Spelieye/superlooper/pdfs/superlooper_schematic.pdf

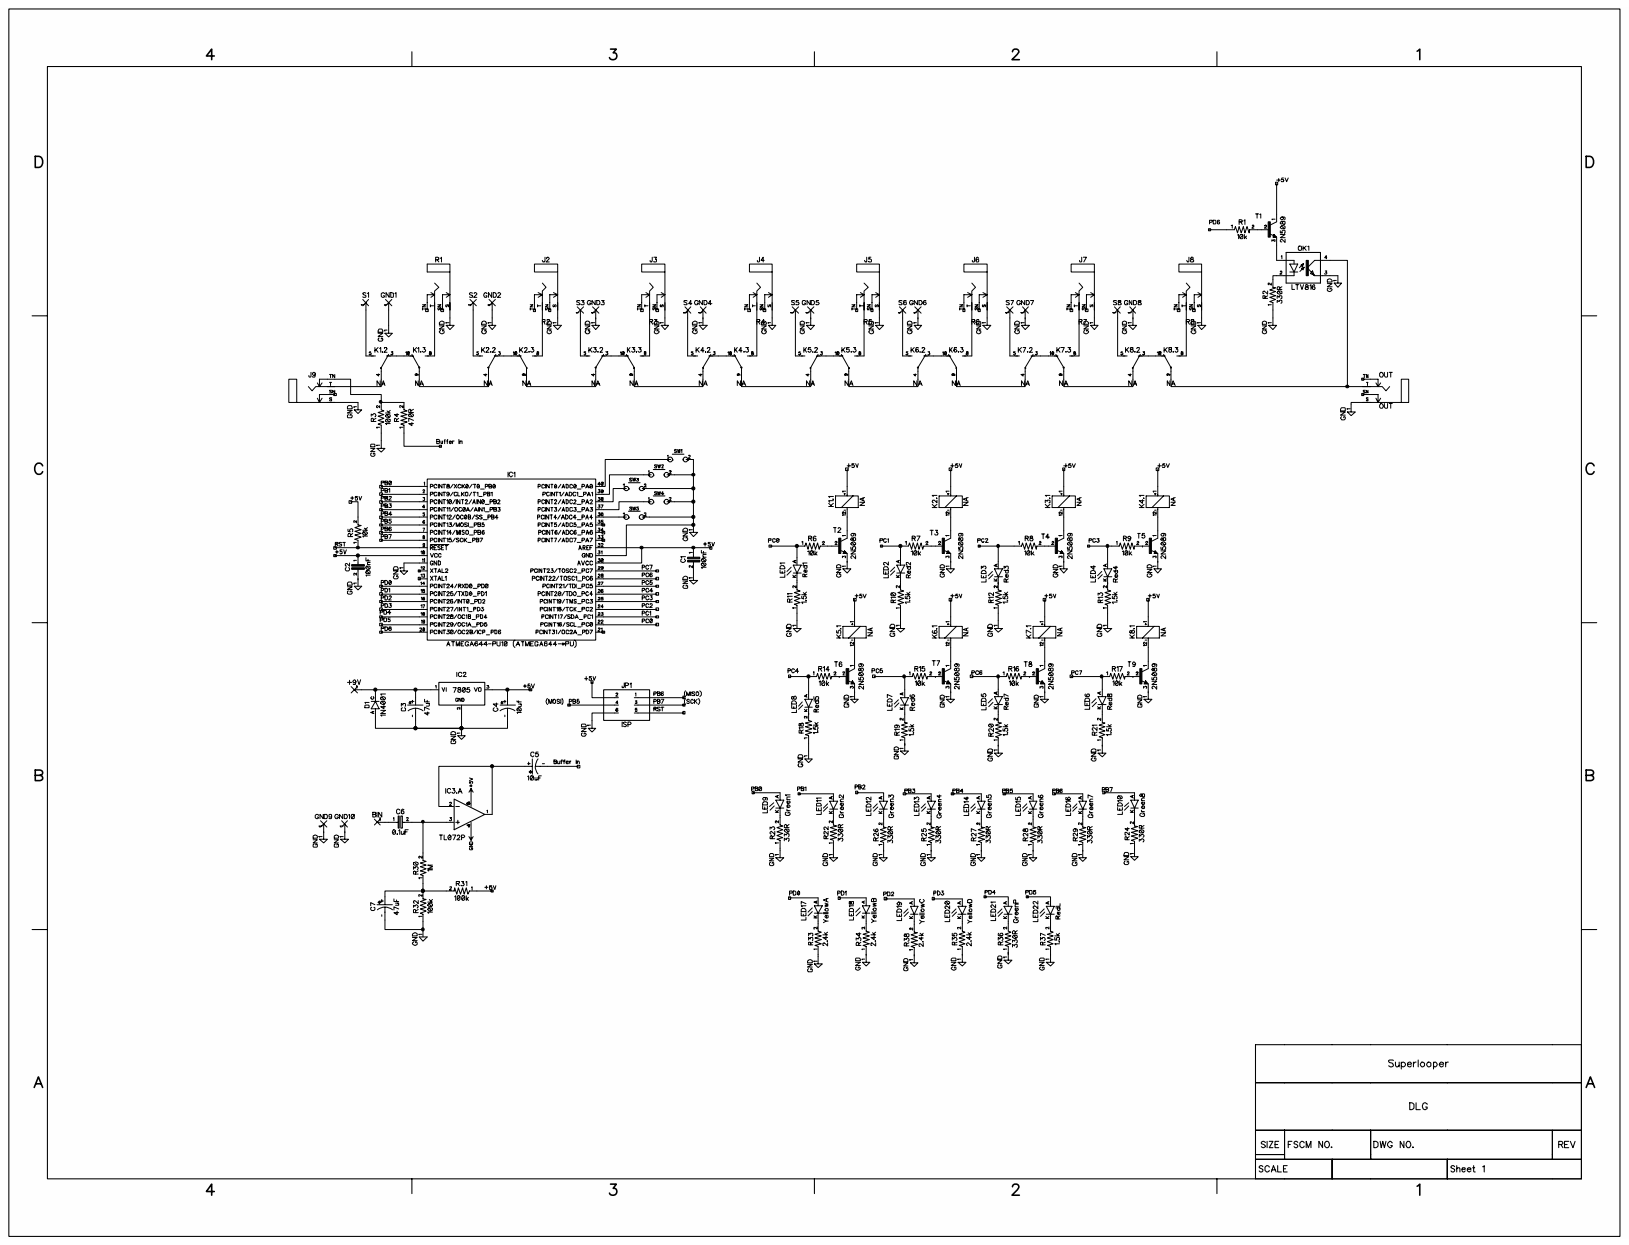
[picture p1: page 1]

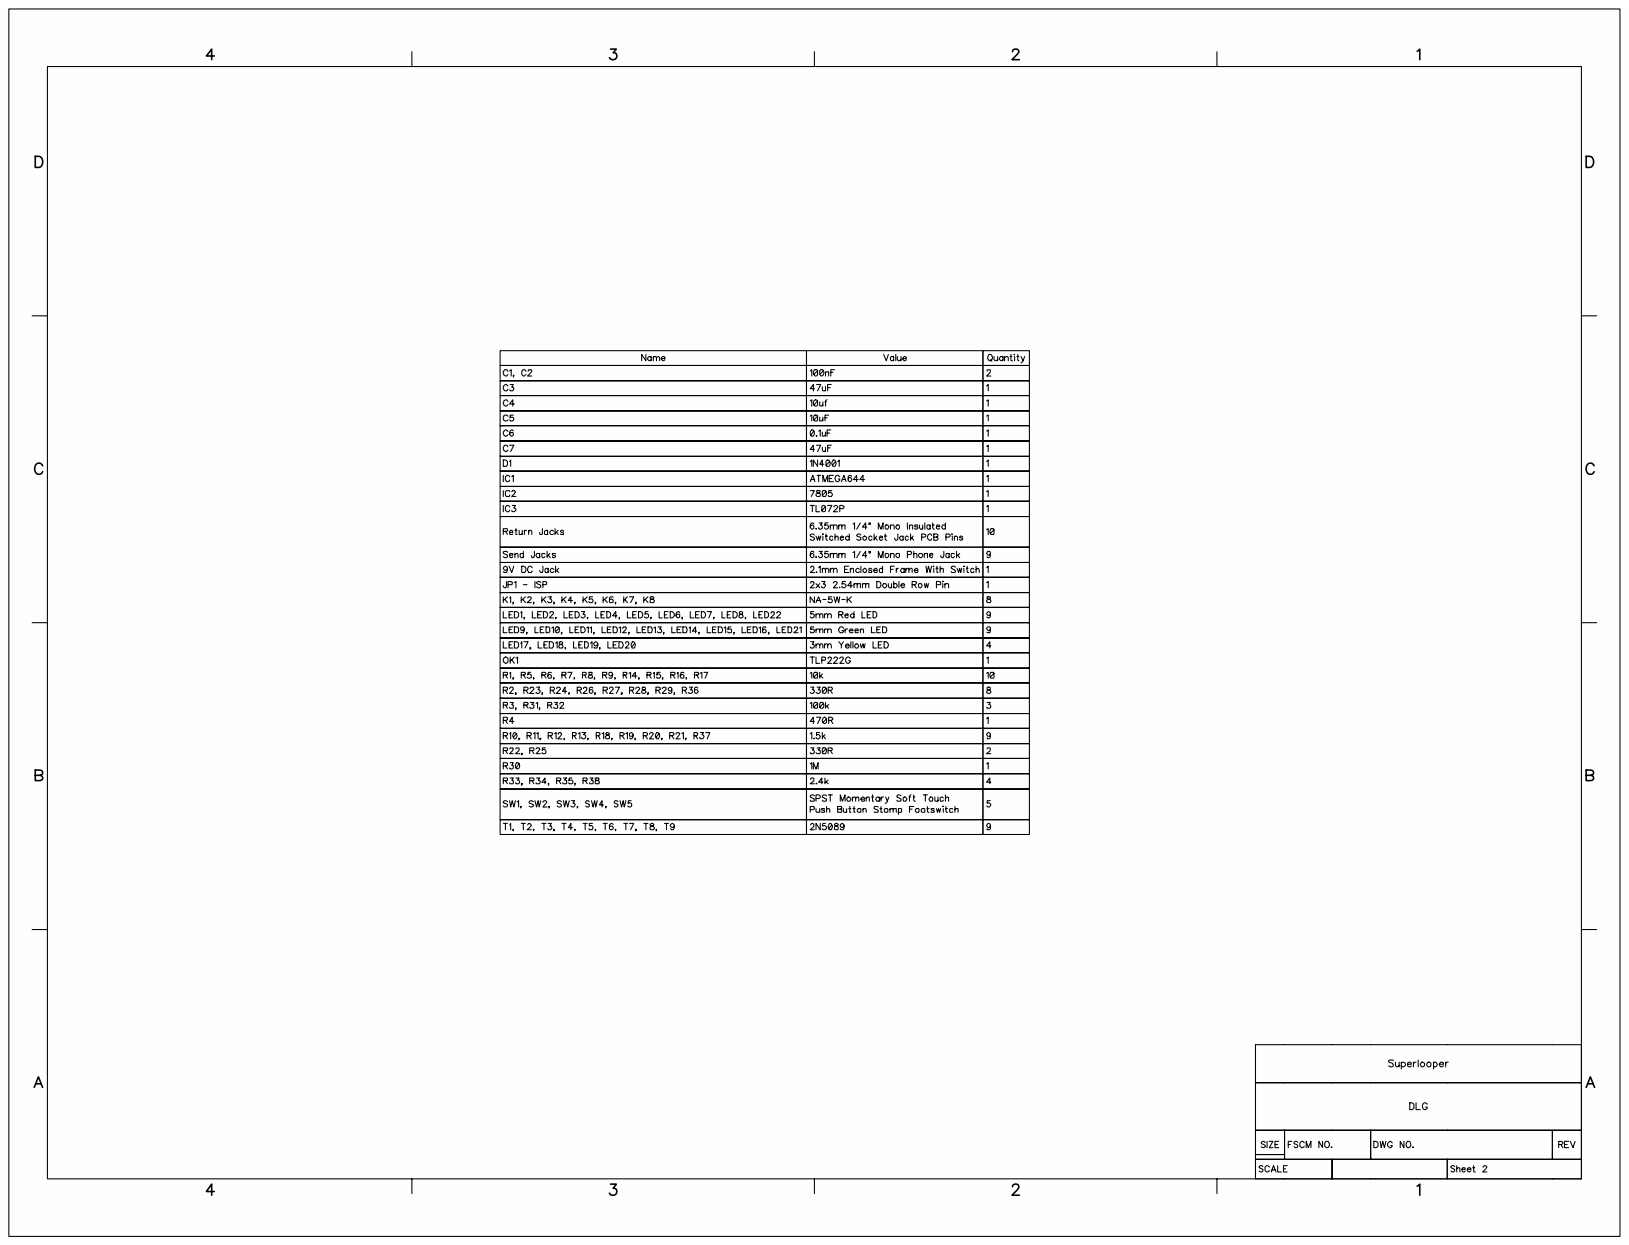
[picture p2: page 2]
