Spelieye/superlooper/pdfs/superlooper_drill_template.pdf

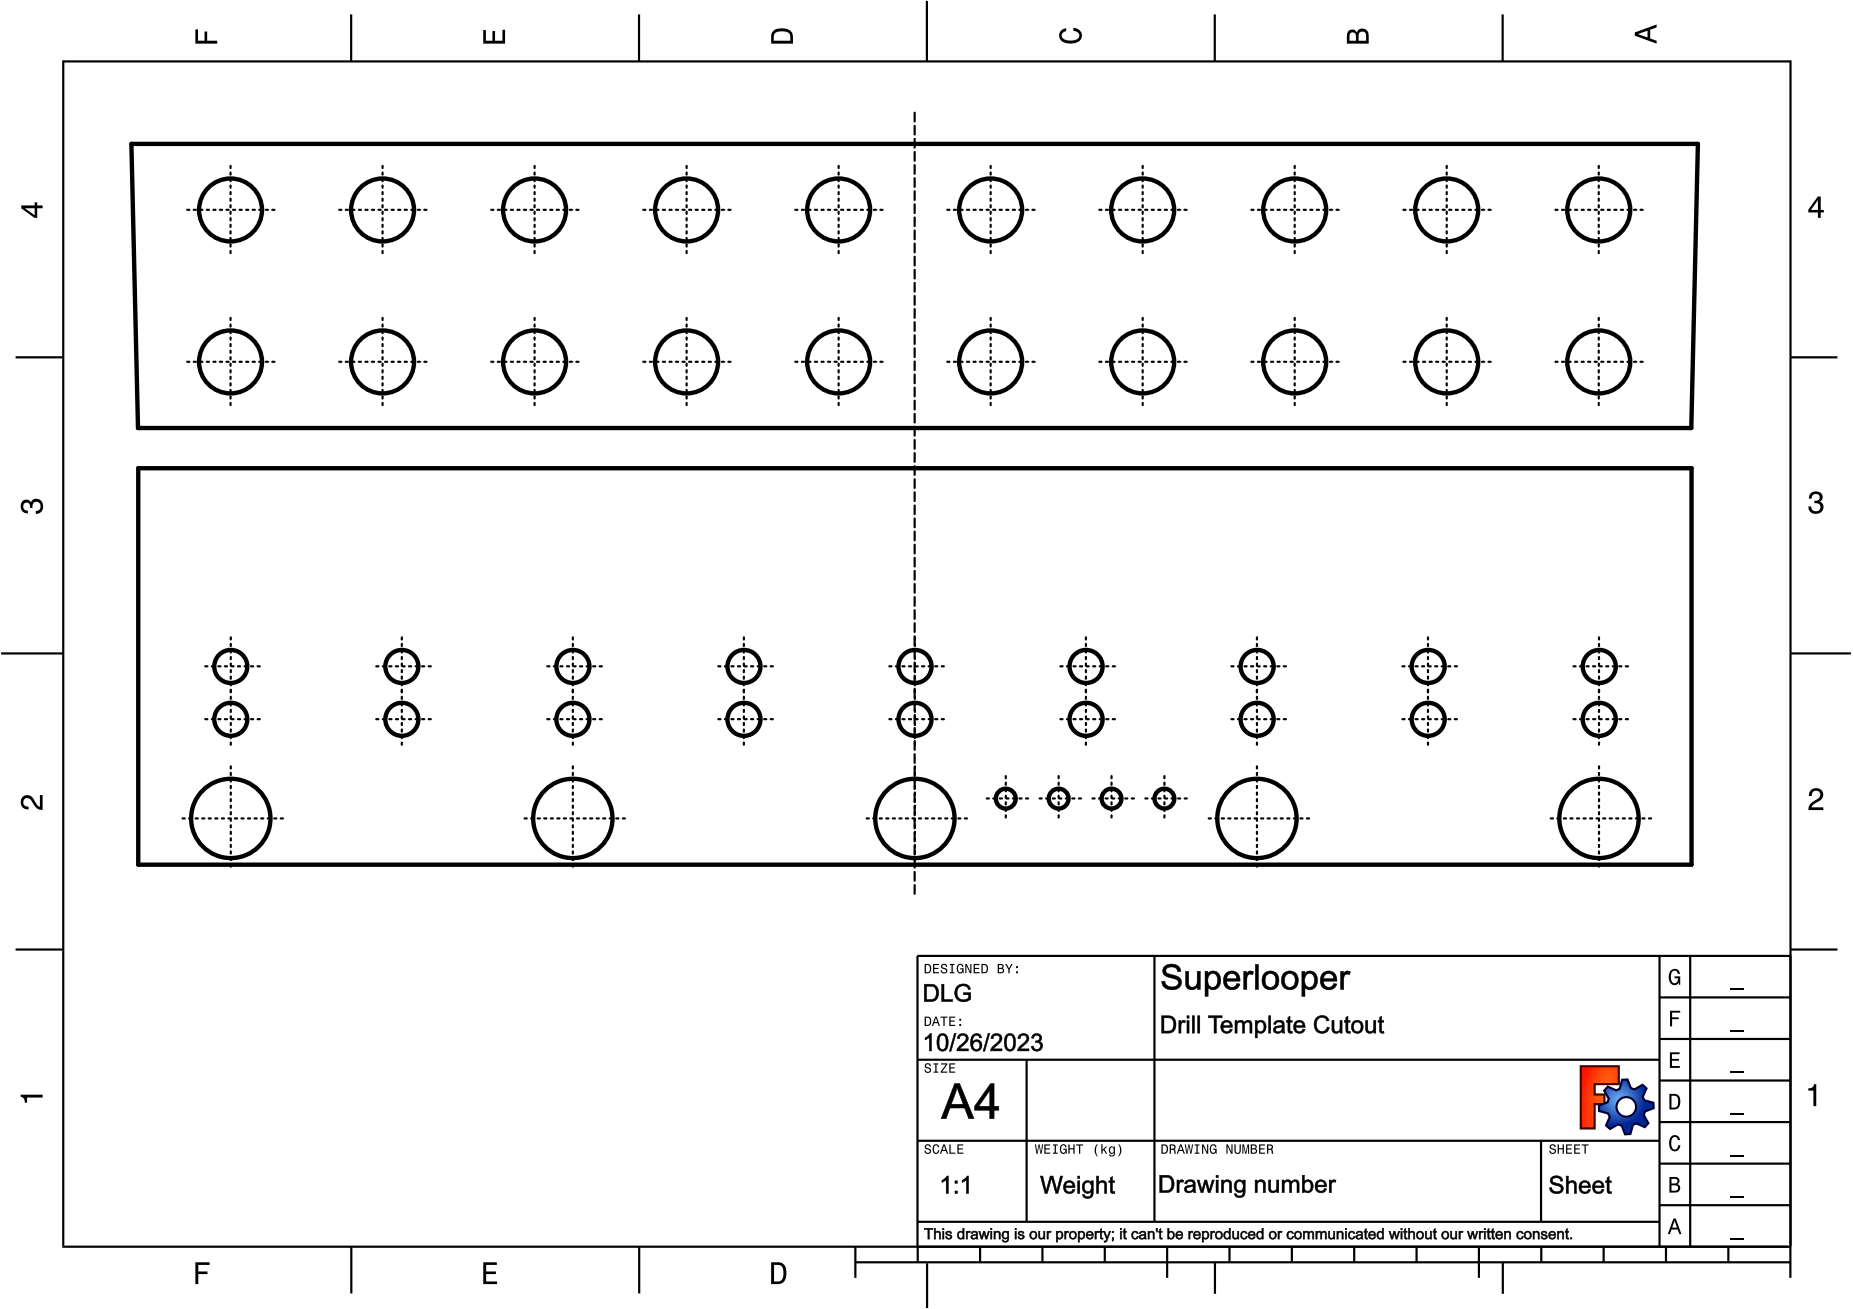
[picture p3: page 1]
