Spelieye/superlooper/pdfs/superlooper_pg1.pdf

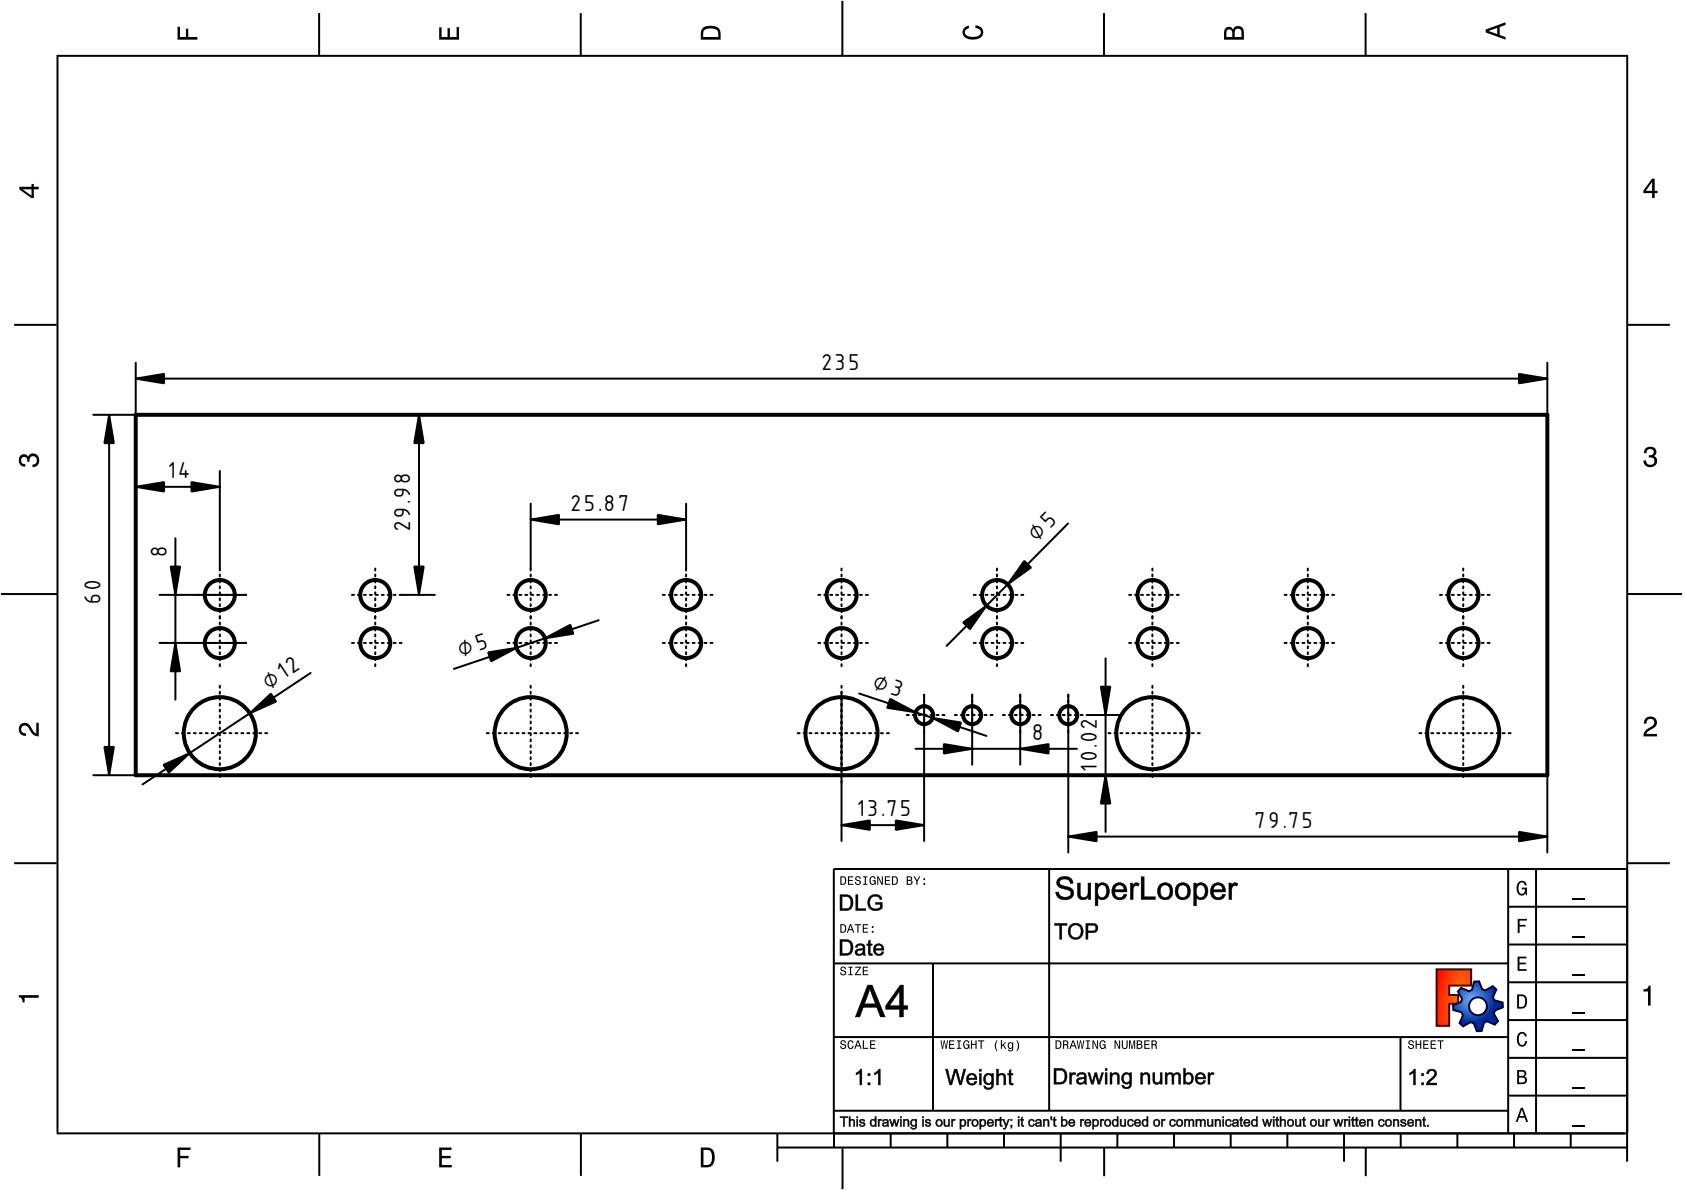
[picture p4: page 1]
