Spelieye/superlooper/pdfs/superlooper_pg2.pdf

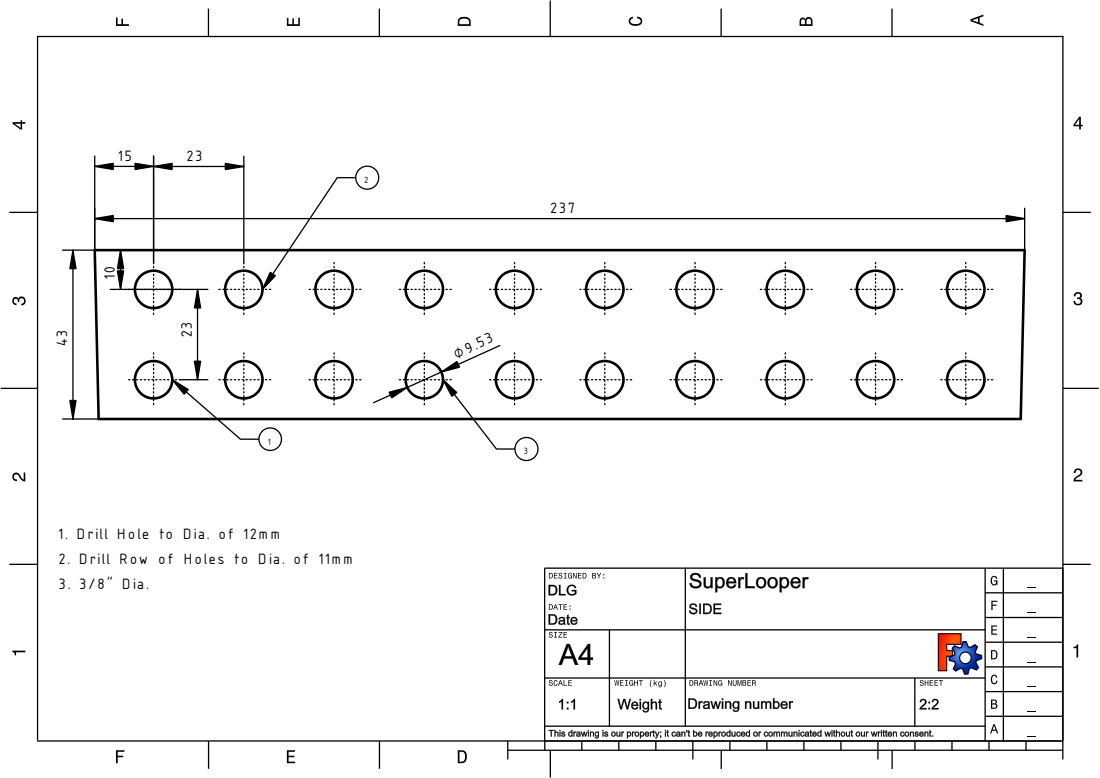
[picture p5: page 1]

1. D rill H ole to D ia. of 12m m
2. D rill R o w of H oles to D ia. of 11m m
