Spelieye/superlooper/(commit log)

2022-05-23 updated code to better deal with global variables set by the switches
2023-10-31 Update README.md
    Added power requirements
2023-10-31 changed interrupt clock prescaler to allow timer execution every 2ms
2023-12-13 changed preset mode loop selection to occur when the switches are pressed rather then when they are released.
2025-12-21 Updates to save the lastest state of the pedal so that it will startup in that mode/bank/loop on next power up
